Zhang-JK/Terminal-One/document/manual/dsi-screen.png

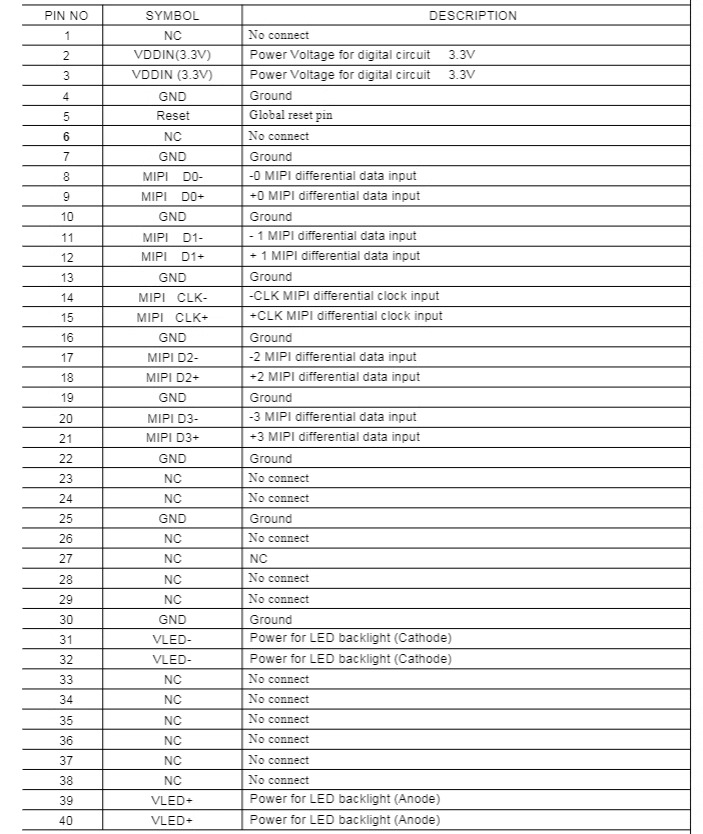
document/manual/dsi-screen.png
