Zhang-JK/Terminal-One/document/manual/mq_sch_v1.6.pdf

# 10uFC30

# 0.1uF R11

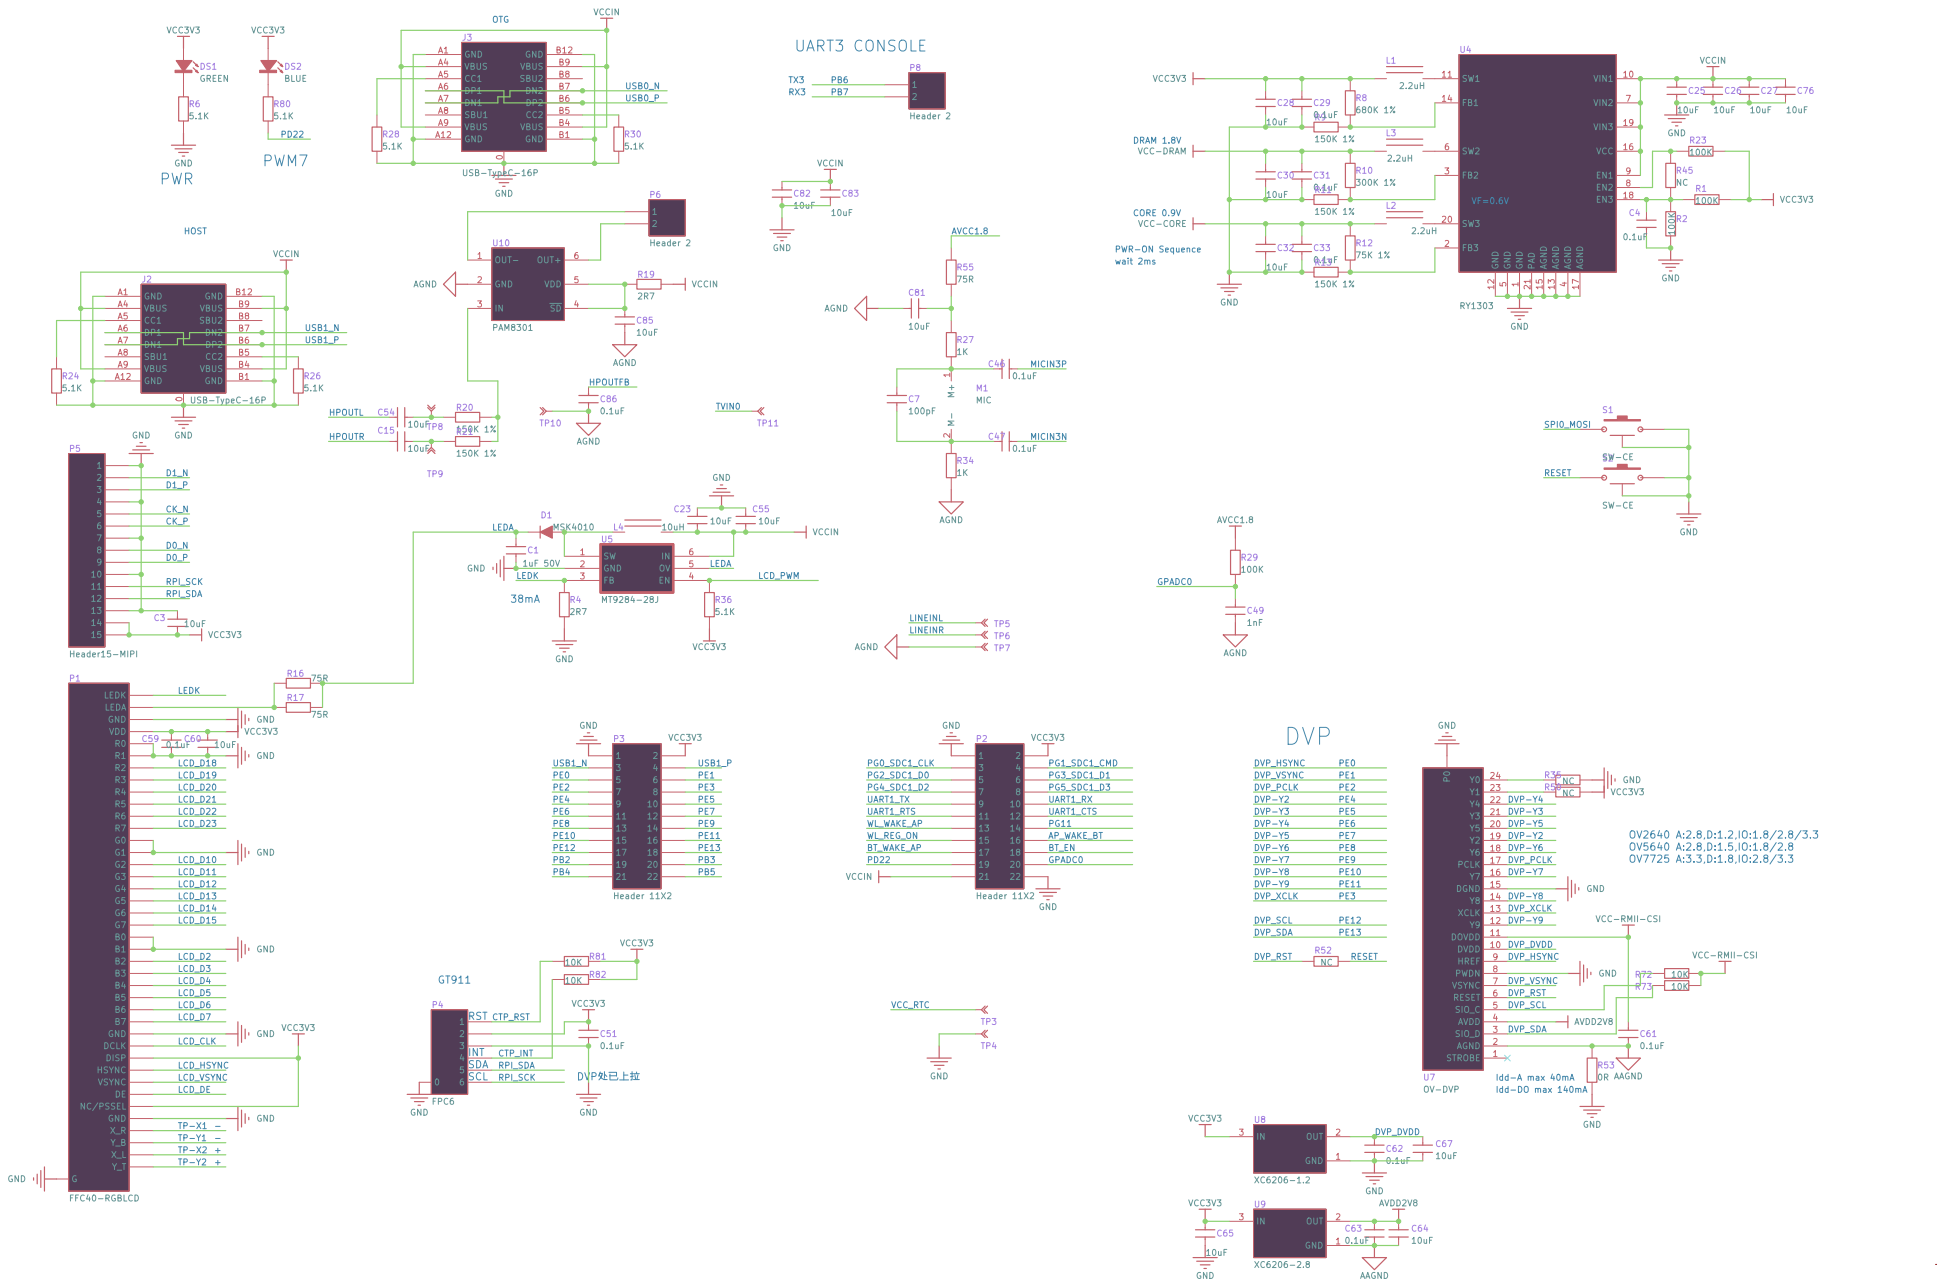
[picture p2: page 1]

0 GND A1 GND A12 VBUS A4 CC1 A5 DP1 A6 DN1 A7 SBU1 A8 VBUS A9 GND B1 GND B12 VBUS B4 CC2 B5 DP2 B6 DN2 B7 SBU2 B8 VBUS B9

1 VIN1 10 SW1 11 GND 12 AGND 13 FB1 14 AGND 15 VCC 16 AGND 17 EN3 18 VIN3 19 FB3 2 SW3 20 PAD 21 FB2 3 AGND

PWR-ON Sequence wait 2ms CORE 0.9V

VCC-RMII-CSI

VSYNC
DE NC/PSSEL GND

VCC3V3 | R84 NC
100K R¹⁴ NC/100K GND | R⁶⁸ ⁴⁷K

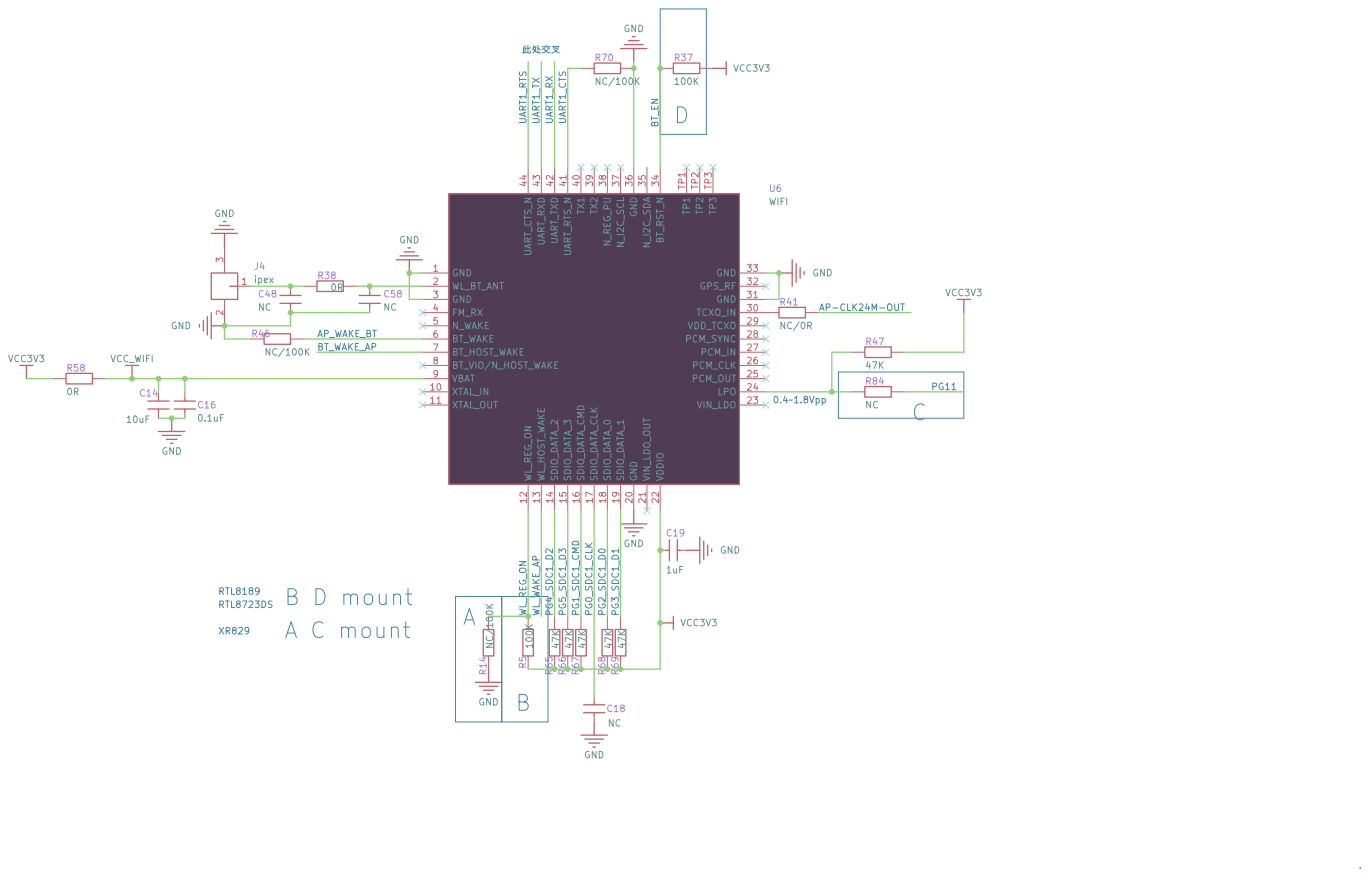
[picture p3: page 2]

þÿkdYN¤SÉ
R70 NC/100K R⁶⁵ ⁴⁷K R⁵ ¹⁰⁰K

# 0.1uFR48

# 10K GND

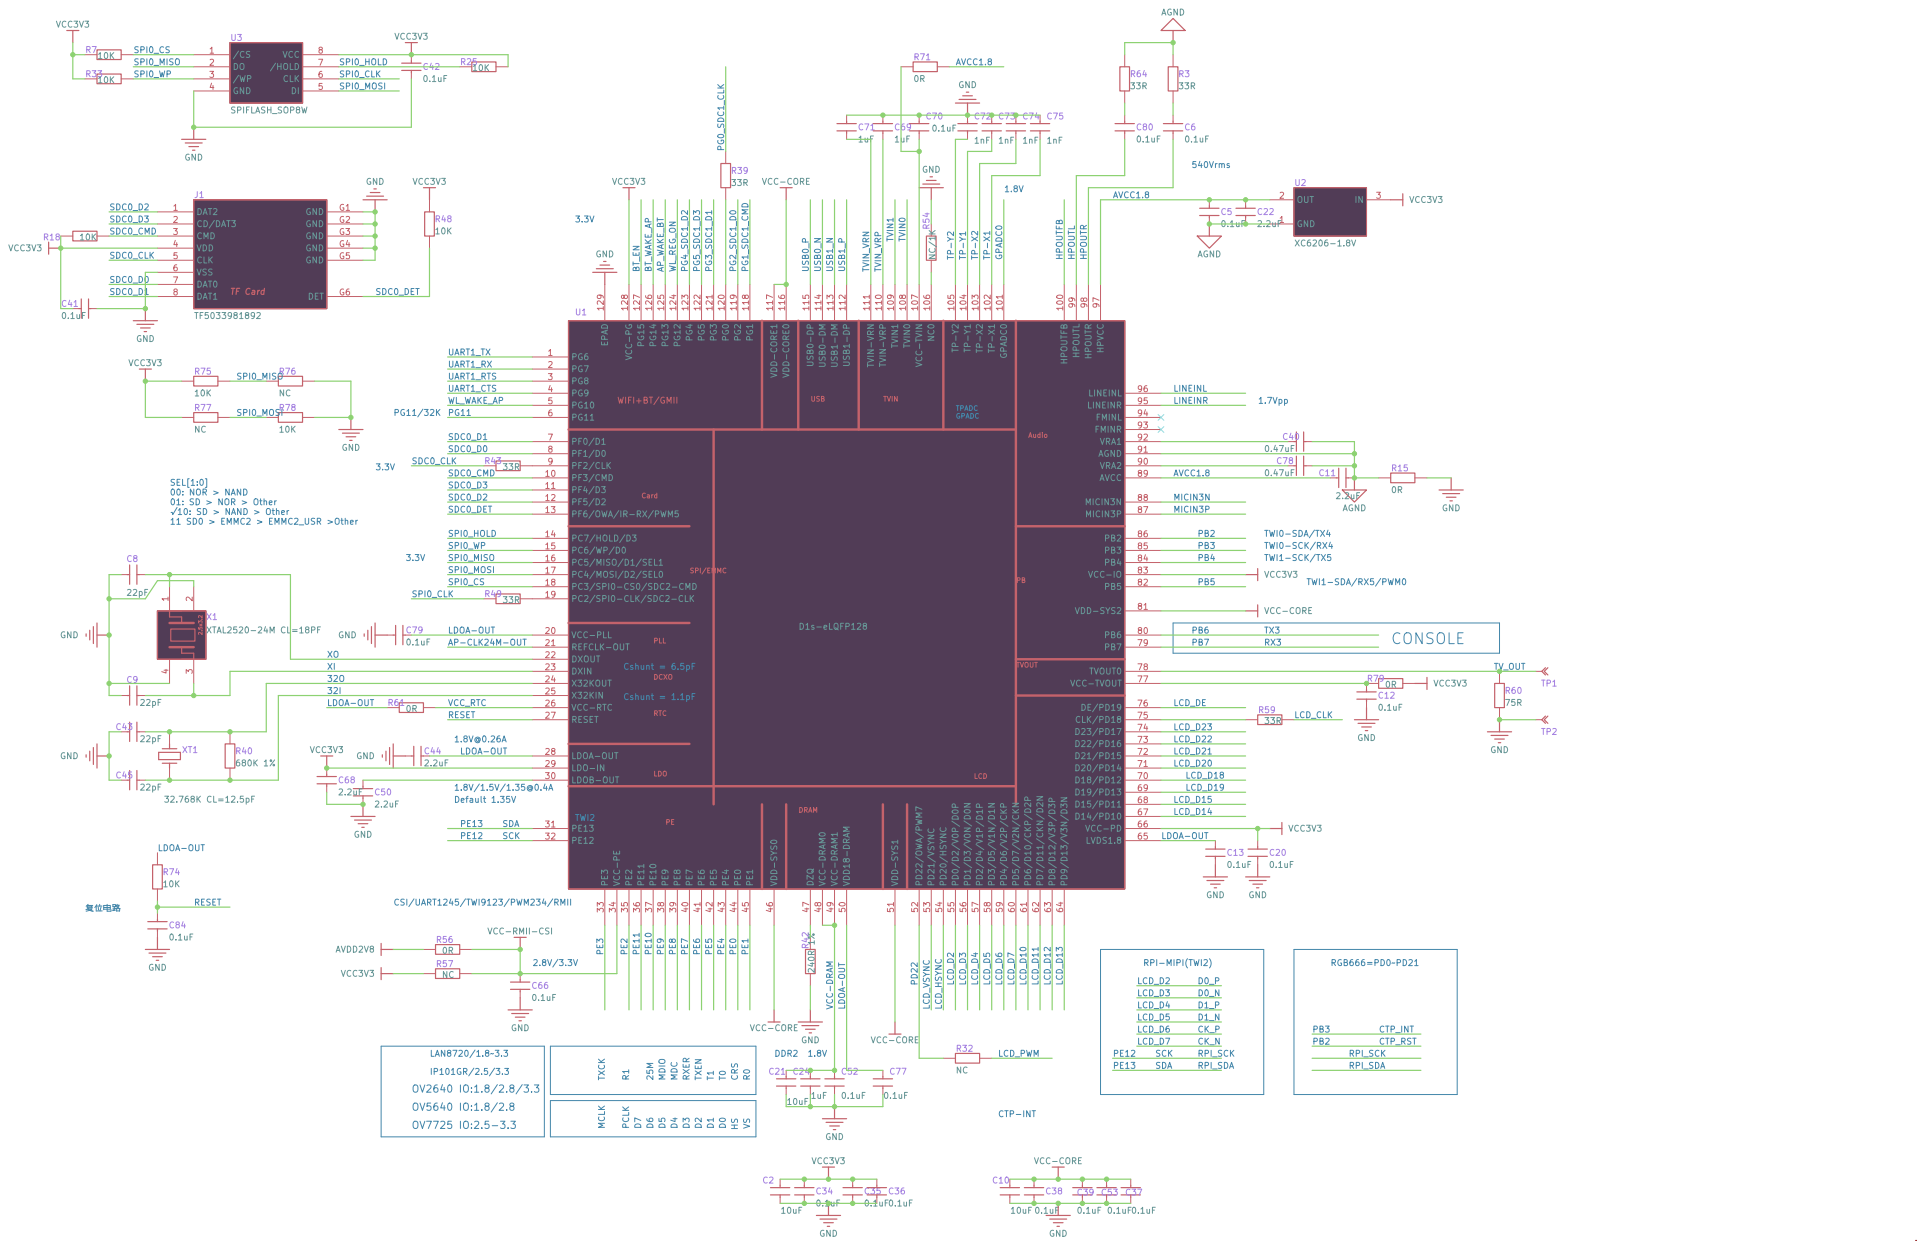
[picture p4: page 3]

OV2640 IO:1.8/2.8/3.3 CSI/UART1245/TWI9123/PWM234/RMII OV7725 IO:2.5-3.3
