Zhang-JK/Terminal-One/hardware/Terminal-One-Core-V1.0/output.pdf

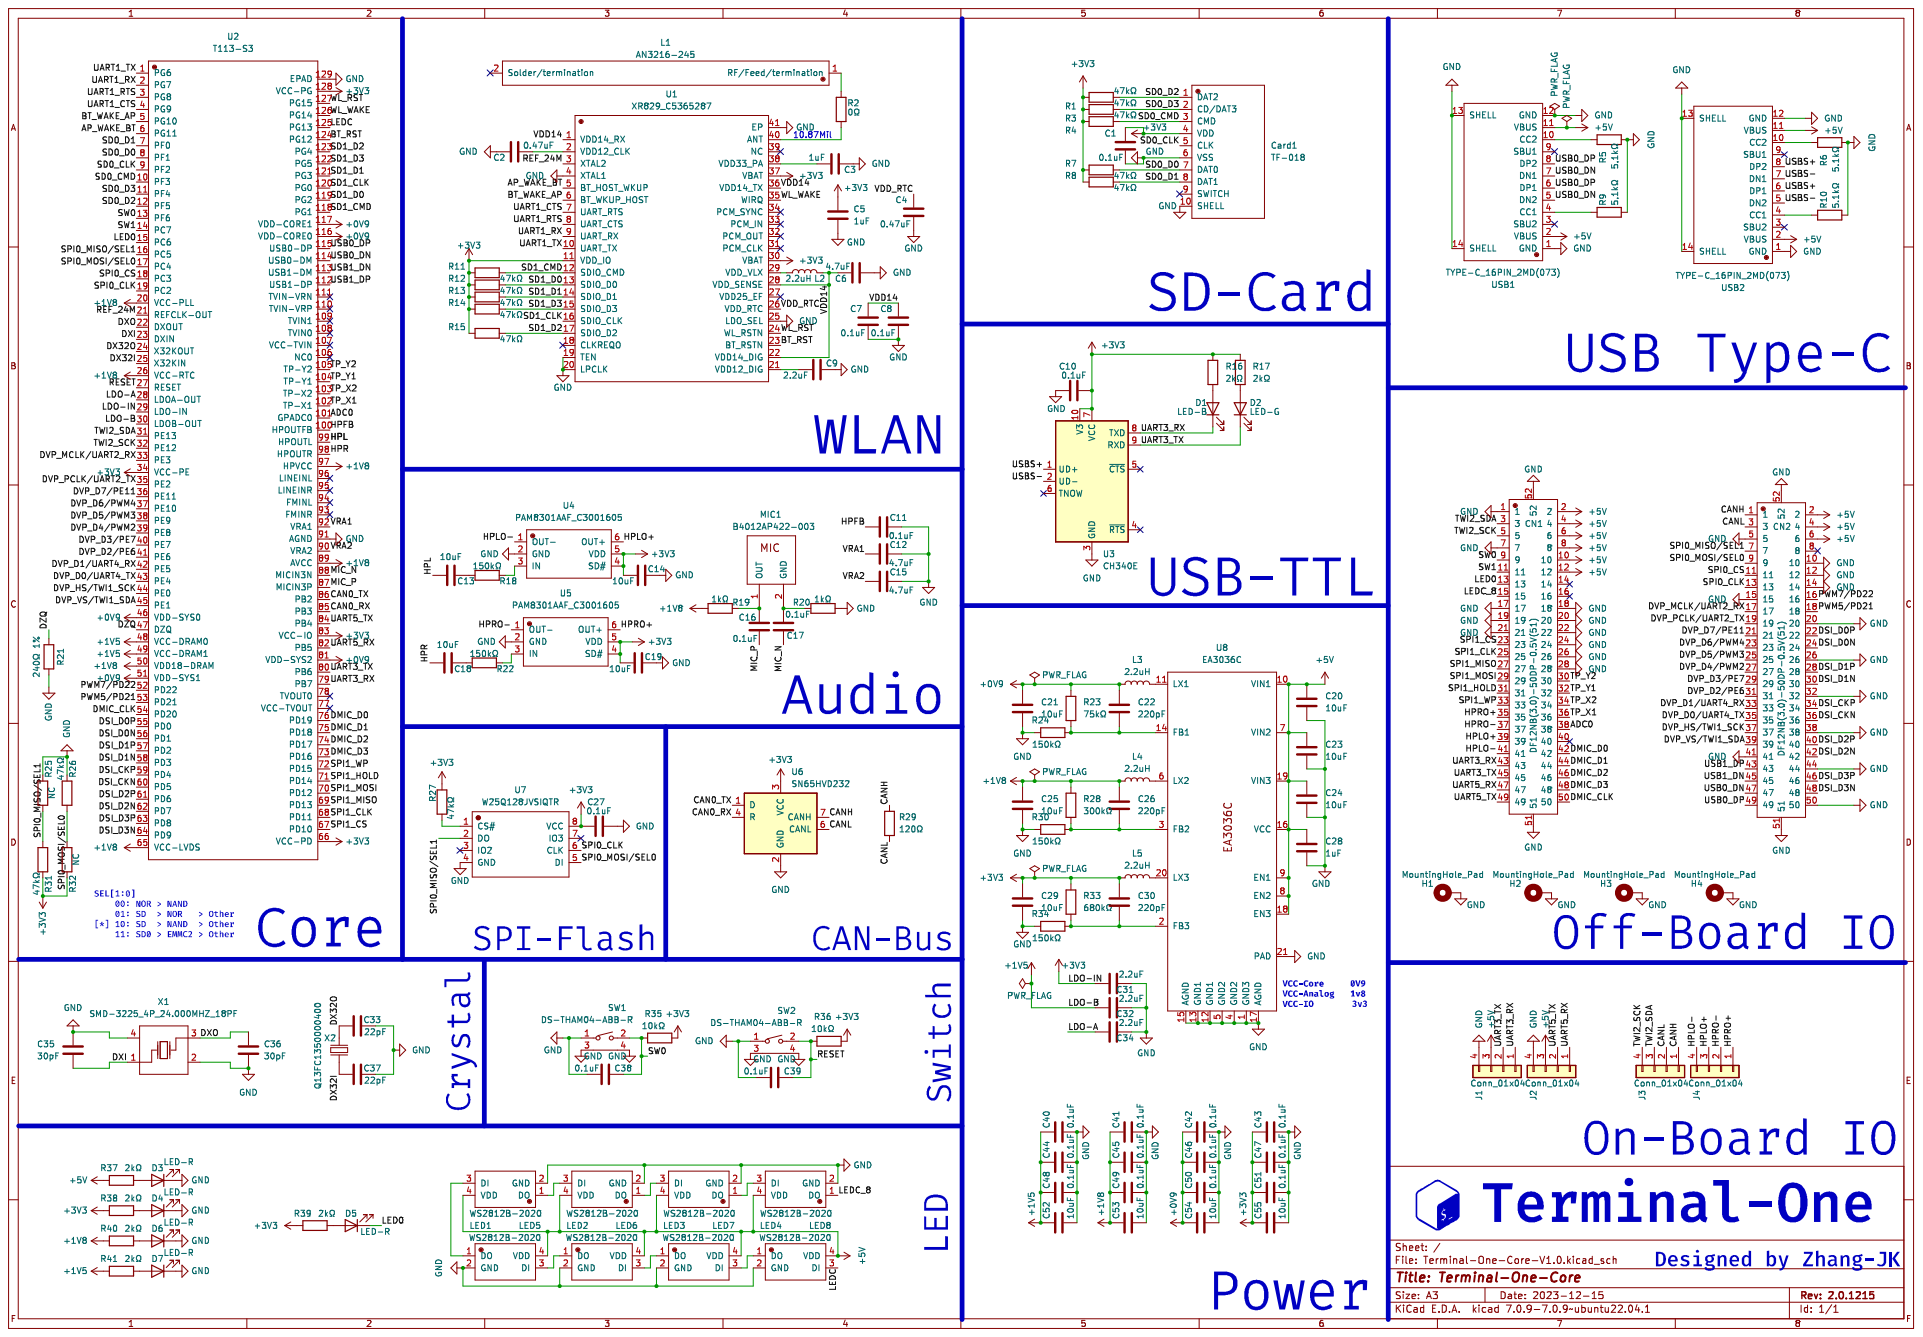
[picture p5: page 1]
