Zhang-JK/Terminal-One/document/manual/14B61A54B428316ECD5F41CF69417D76.pdf

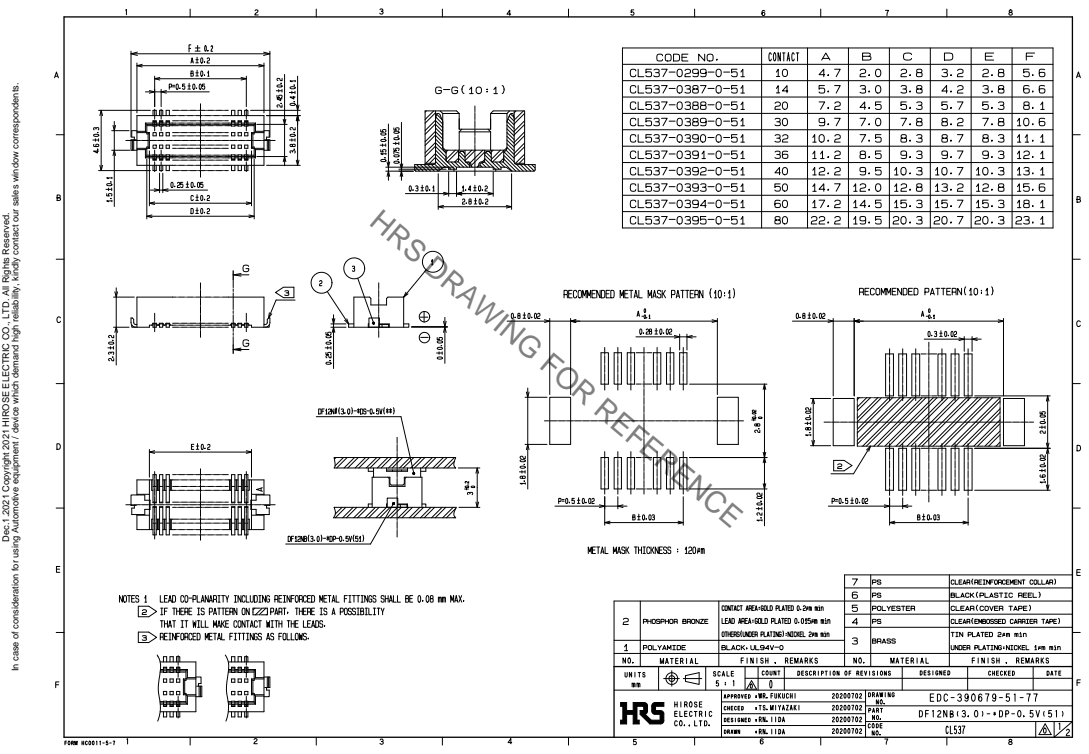
[picture p6: page 1]

HRS DRAWING FOR REFERENCE

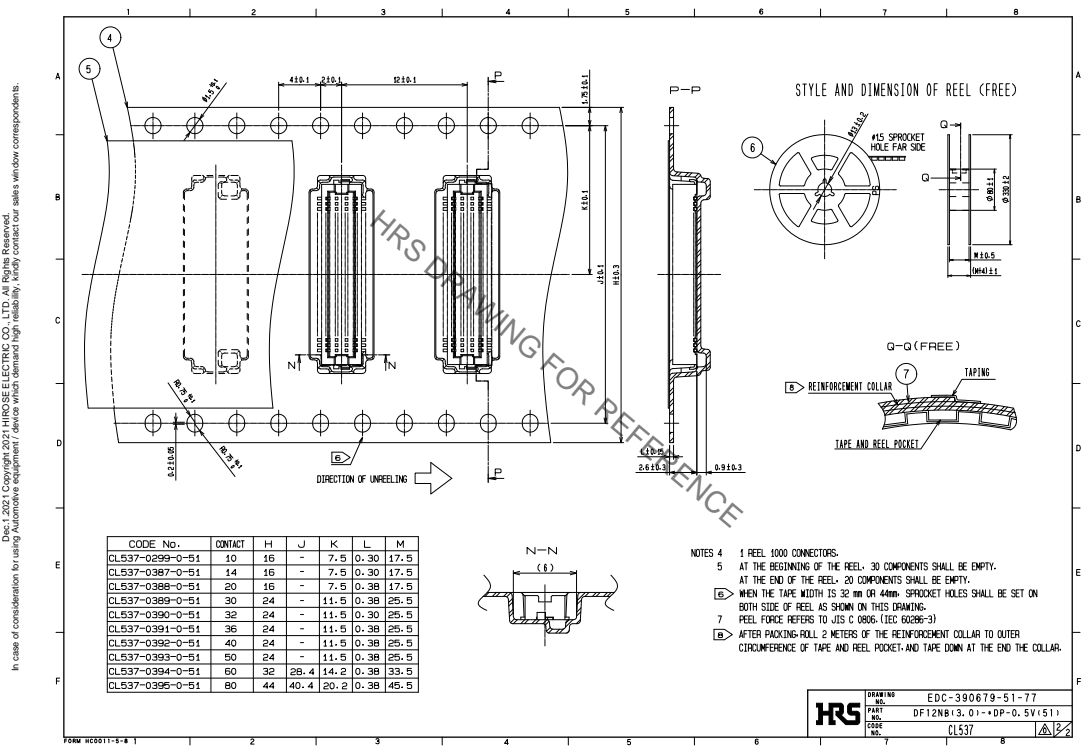
[picture p7: page 2]

HRS DRAWING FOR REFERENCE
