Zhang-JK/Terminal-One/hardware/Terminal-One-Core-V1.0/Terminal-One-Core-V1.0.kicad_pcb

## KiCad design hardware/Terminal-One-Core-V1.0/Terminal-One-Core-V1.0.kicad_pcb (2024-01-20)

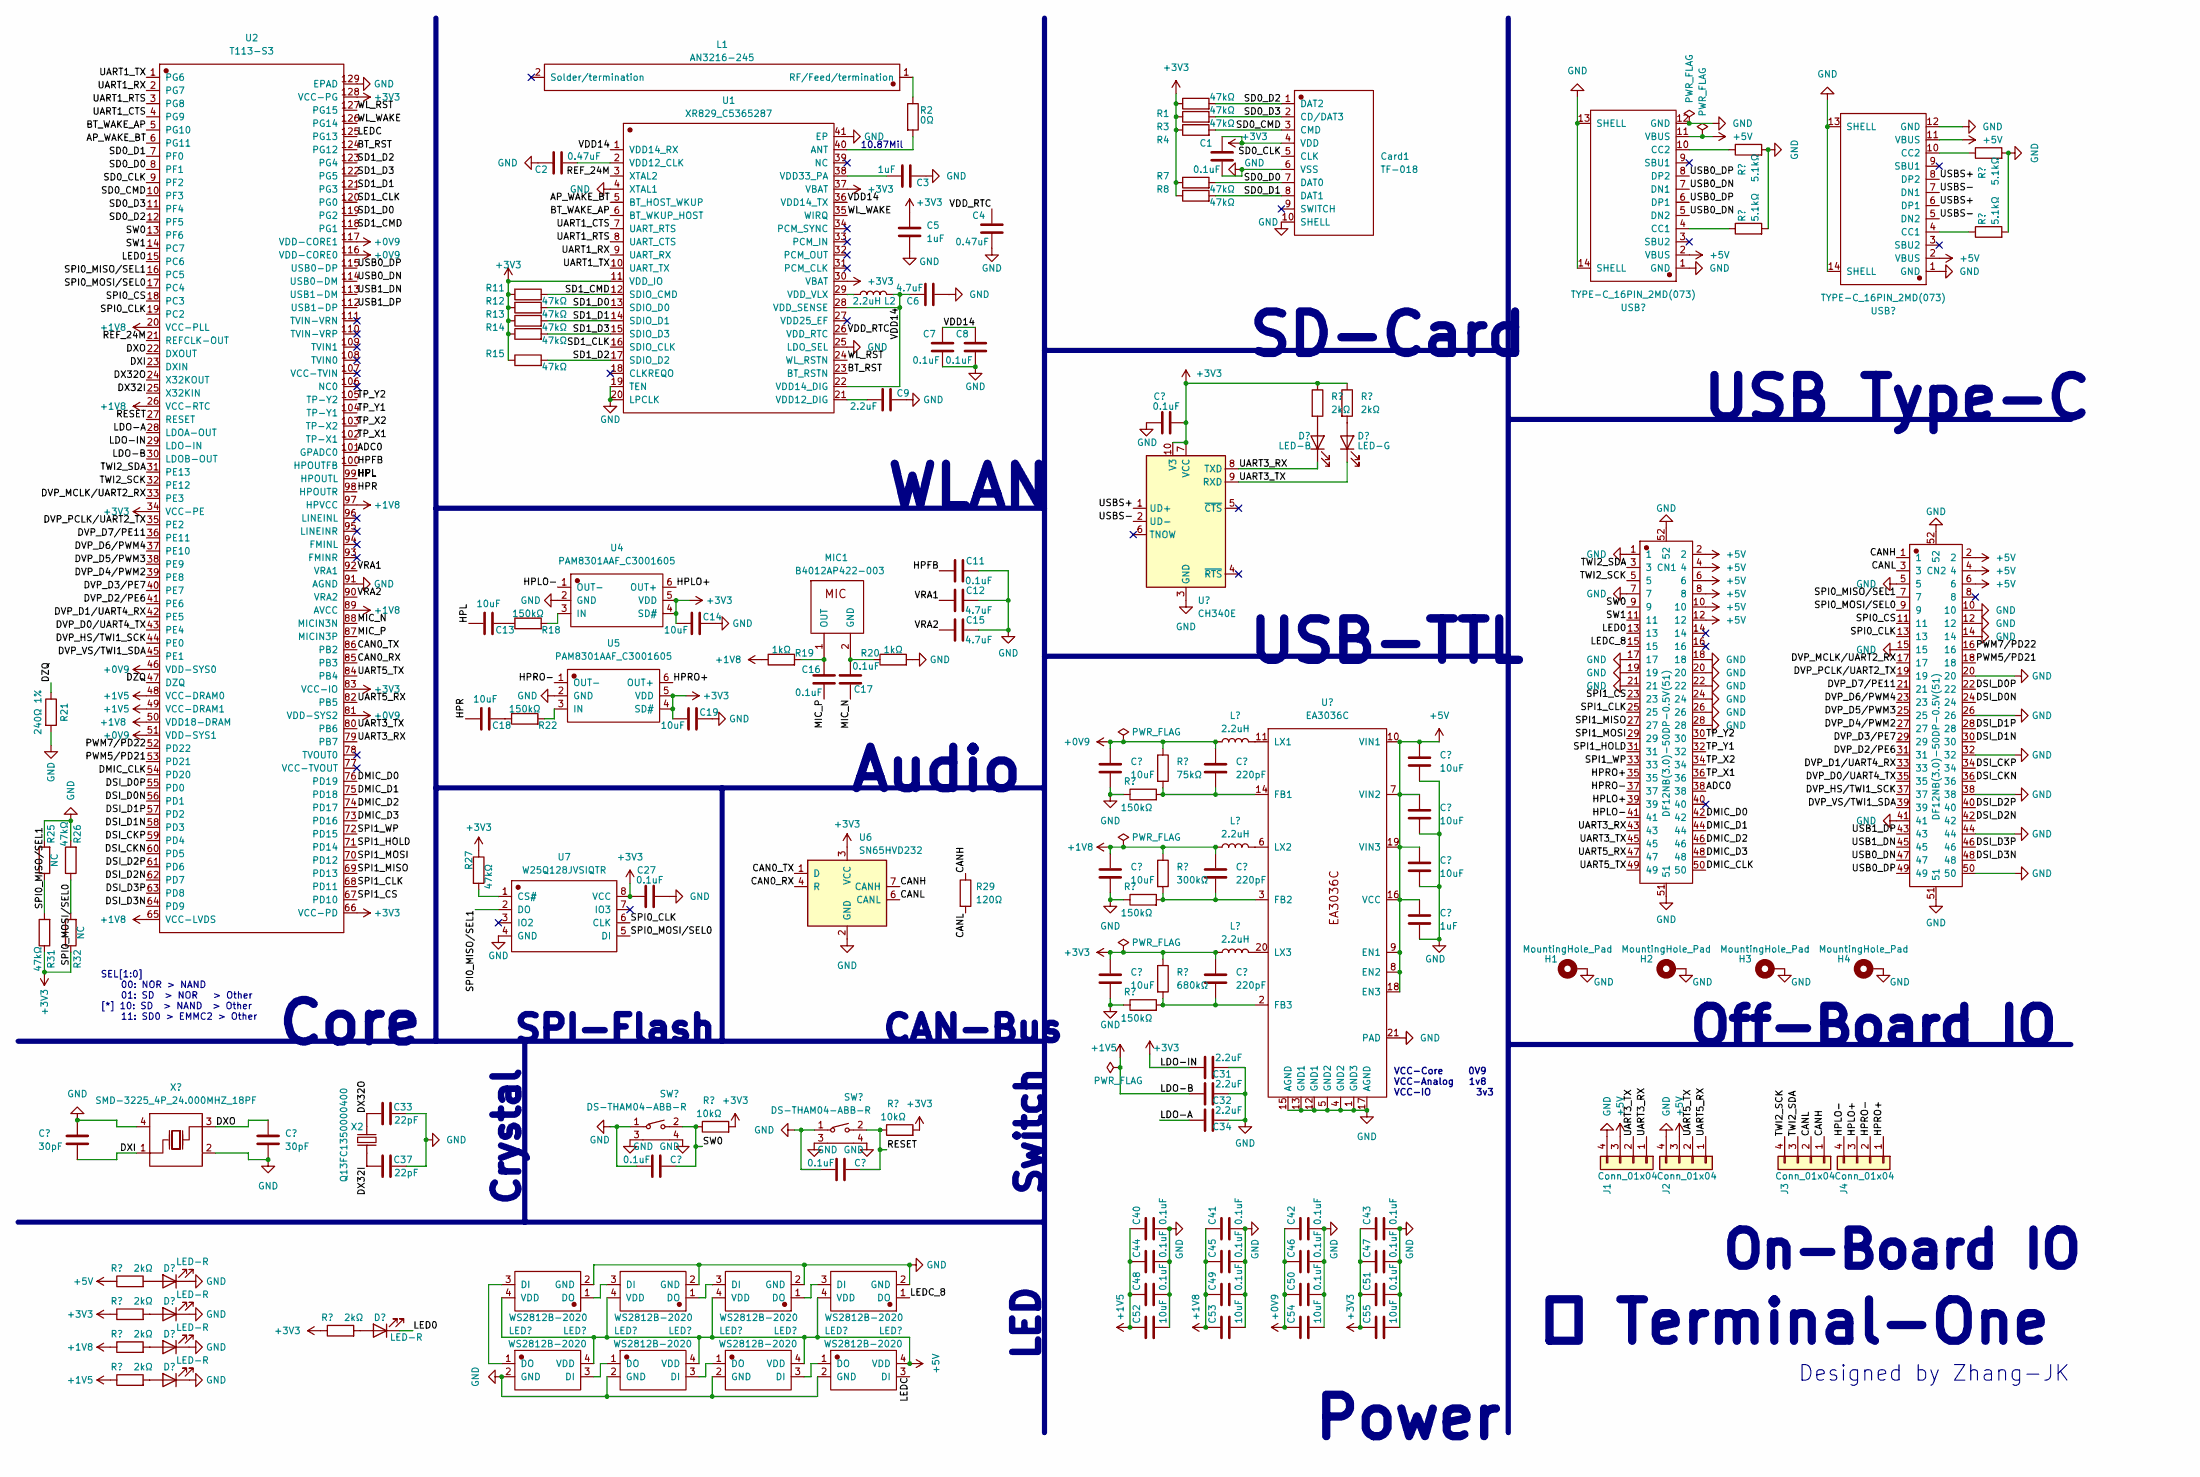
[picture p8: schematic Terminal-One-Core-V1.0.kicad_sch, Terminal-One-Core]

Parts:
C1, C7, C8, C10, C11, C16, C17, C27, C38, C39, C40, C41, C42, C43, C44, C45, C46, C47, C48, C49, C50, C51: 0.1uF; C_0402_1005Metric
C2, C4: 0.47uF; C_0402_1005Metric
C3, C5, C28: 1uF; C_0402_1005Metric
C6, C12, C15: 4.7uF; C_0603_1608Metric
C9, C31, C32, C34: 2.2uF; C_0603_1608Metric
C13, C14, C18, C19, C20, C23, C24, C52, C53, C54, C55: 10uF; C_0603_1608Metric
C21, C25, C29: 10uF; C_0805_2012Metric
C22, C26, C30: 220pF; C_0603_1608Metric
C33, C37: 22pF; C_0402_1005Metric
C35, C36: 30pF; C_0402_1005Metric
CN1, CN2: DF12NB(3.0)-50DP-0.5V(51); CONN-SMD_50P-P0.50_DF12NB3.0-50DP-0.5V-51
Card1: TF-018; TF-SMD_TF-018
D1: LED-B; LED_0603_1608Metric
D2: LED-G; LED_0603_1608Metric
D3, D4, D5, D6, D7: LED-R; LED_0603_1608Metric
H1, H2, H3, H4: MountingHole_Pad; MountingHole_2.7mm_M2.5_ISO14580_Pad_TopOnly
J1, J2, J3, J4: Conn_01x04; JST_GH_BM04B-GHS-TBT_1x04-1MP_P1.25mm_Vertical
L1: AN3216-245; ANT-SMD_L3.2-W1.6-A
L2, L3, L4, L5: 2.2uH; L_0805_2012Metric
LED1, LED2, LED3, LED4, LED5, LED6, LED7, LED8: WS2812B-2020; LED-SMD_4P-L2.0-W2.0-TL_WS2812B-2020
MIC1: B4012AP422-003; MIC-TH_BD4.0-P1.40-D0.3-L
R1, R3, R4, R7, R8, R11, R12, R13, R14, R15, R26, R27, R31: 47kΩ; R_0402_1005Metric
R2: 0Ω; R_0402_1005Metric
R5, R6, R9, R10: 5.1kΩ; R_0402_1005Metric
R16, R17, R37, R38, R39, R40, R41: 2kΩ; R_0402_1005Metric
R18, R22, R24, R30, R34: 150kΩ; R_0402_1005Metric
R19, R20: 1kΩ; R_0402_1005Metric
R21: 240Ω 1%; R_0402_1005Metric
R23: 75kΩ; R_0402_1005Metric
R25, R32: NC; R_0402_1005Metric
R28: 300kΩ; R_0402_1005Metric
R29: 120Ω; R_0402_1005Metric
R33: 680kΩ; R_0402_1005Metric
R35, R36: 10kΩ; R_0402_1005Metric
SW1, SW2: DS-THAM04-ABB-R; SW-SMD_D-SWITCH_DS-THAM04-ABB-R
U1: XR829_C5365287; QFN-40_L5.0-W5.0-P0.40-BL-EP3.4
U2: T113-S3; TQFP-128_L14.0-W14.0-P0.40-LS16.0-BL-EP6.4
U3: CH340E; MSOP-10_3x3mm_P0.5mm
U4, U5: PAM8301AAF_C3001605; SOT-23-6_L2.9-W1.6-P0.95-LS2.8-BR
U6: SN65HVD232; SOIC-8_3.9x4.9mm_P1.27mm
U7: W25Q128JVSIQTR; SOIC-8_L5.3-W5.3-P1.27-LS8.0-BL
U8: EA3036C; WQFN-20-1EP_3x3mm_P0.4mm_EP1.7x1.7mm_ThermalVias
USB1, USB2: TYPE-C_16PIN_2MD(073); USB-C-SMD_TYPE-C-6PIN-2MD-073
X1: SMD-3225_4P_24.000MHZ_18PF; CRYSTAL-SMD_4P-L3.2-W2.5-BL
X2: Q13FC1350000400; FC-135R_L3.2-W1.5

Connections:
+0V9: C21.1, C22.1, C42.1, C46.1, C50.1, C54.1, L3.1, R23.1, U2.46 (VDD-SYS0), U2.51 (VDD-SYS1), U2.81 (VDD-SYS2), U2.116 (VDD-CORE0), U2.117 (VDD-CORE1); also elsewhere on the board
+1V5: C32.1, C40.1, C44.1, C48.1, C52.1, R41.1, U2.30 (LDOB-OUT), U2.48 (VCC-DRAM0), U2.49 (VCC-DRAM1); also elsewhere on the board
+1V8: C25.1, C26.1, C41.1, C45.1, C49.1, C53.1, L4.1, R19.1, R28.1, R40.1, U2.20 (VCC-PLL), U2.26 (VCC-RTC), U2.50 (VDD18-DRAM), U2.65 (VCC-LVDS), U2.89 (AVCC), U2.97 (HPVCC); also elsewhere on the board
+3V3: C1.1, C5.1, C10.2, C14.1, C19.1, C27.1, C29.1, C30.1, C31.1, C43.1, C47.1, C51.1, C55.1, Card1.4 (VDD), L5.1, R1.1, R3.1, R4.1, R7.1, R8.1, R11.1, R12.1, R13.1, R14.1, R15.1, R16.1, R17.1, R27.1, R31.1, R32.1, R33.1, R35.2, R36.2, R38.1, R39.1, U1.11 (VDD_IO), U1.30 (VBAT), U1.37 (VBAT), U2.29 (LDO-IN), U2.34 (VCC-PE), U2.66 (VCC-PD), U2.83 (VCC-IO), U2.128 (VCC-PG), U3.7 (VCC), U3.10 (V3), U4.4 (SD#), U4.5 (VDD), U5.4 (SD#), U5.5 (VDD), U6.3 (VCC), U7.8 (VCC); also elsewhere on the board
+5V: C20.1, C23.1, C24.1, C28.1, CN1.2, CN1.4, CN1.6, CN1.8, CN1.10, CN1.12, CN2.2, CN2.4, CN2.6, J1.3, J2.3, LED1.4 (VDD), LED2.4 (VDD), LED3.4 (VDD), LED4.4 (VDD), LED5.4 (VDD), LED6.4 (VDD), LED7.4 (VDD), LED8.4 (VDD), R37.1, U8.7 (VIN2), U8.8 (EN2), U8.9 (EN1), U8.10 (VIN1), U8.16 (VCC), U8.18 (EN3), U8.19 (VIN3), USB1.2 (VBUS), USB1.11 (VBUS), USB2.2 (VBUS), USB2.11 (VBUS)
/ADC0: CN1.38, U2.101 (GPADC0); also elsewhere on the board
/AP_WAKE_BT: U1.5 (BT_HOST_WKUP), U2.6 (PG11); also elsewhere on the board
/BT_RST: U1.23 (BT_RSTN), U2.124 (PG12); also elsewhere on the board
/BT_WAKE_AP: U1.6 (BT_WKUP_HOST), U2.5 (PG10); also elsewhere on the board
/CAN0_RX: U2.85 (PB3), U6.4 (R); also elsewhere on the board
/CAN0_TX: U2.86 (PB2), U6.1 (D); also elsewhere on the board
/CANH: CN2.1, J3.1, R29.1, U6.7 (CANH)
/CANL: CN2.3, J3.2, R29.2, U6.6 (CANL)
/DMIC_CLK: CN1.50, U2.54 (PD20); also elsewhere on the board
/DMIC_D0: CN1.42, U2.76 (PD19); also elsewhere on the board
/DMIC_D1: CN1.44, U2.75 (PD18); also elsewhere on the board
/DMIC_D2: CN1.46, U2.74 (PD17); also elsewhere on the board
/DMIC_D3: CN1.48, U2.73 (PD16); also elsewhere on the board
/DSI_CKN: CN2.36, U2.60 (PD5); also elsewhere on the board
/DSI_CKP: CN2.34, U2.59 (PD4); also elsewhere on the board
/DSI_D0N: CN2.24, U2.56 (PD1); also elsewhere on the board
/DSI_D0P: CN2.22, U2.55 (PD0); also elsewhere on the board
/DSI_D1N: CN2.30, U2.58 (PD3); also elsewhere on the board
/DSI_D1P: CN2.28, U2.57 (PD2); also elsewhere on the board
/DSI_D2N: CN2.42, U2.62 (PD7); also elsewhere on the board
/DSI_D2P: CN2.40, U2.61 (PD6); also elsewhere on the board
/DSI_D3N: CN2.48, U2.64 (PD9); also elsewhere on the board
/DSI_D3P: CN2.46, U2.63 (PD8); also elsewhere on the board
/DVP_D0/UART4_TX: CN2.35, U2.43 (PE4); also elsewhere on the board
/DVP_D1/UART4_RX: CN2.33, U2.42 (PE5); also elsewhere on the board
/DVP_D2/PE6: CN2.31, U2.41 (PE6); also elsewhere on the board
/DVP_D3/PE7: CN2.29, U2.40 (PE7); also elsewhere on the board
/DVP_D4/PWM2: CN2.27, U2.39 (PE8); also elsewhere on the board
/DVP_D5/PWM3: CN2.25, U2.38 (PE9); also elsewhere on the board
/DVP_D6/PWM4: CN2.23, U2.37 (PE10); also elsewhere on the board
/DVP_D7/PE11: CN2.21, U2.36 (PE11); also elsewhere on the board
/DVP_HS/TWI1_SCK: CN2.37, U2.44 (PE0); also elsewhere on the board
/DVP_MCLK/UART2_RX: CN2.17, U2.33 (PE3); also elsewhere on the board
/DVP_PCLK/UART2_TX: CN2.19, U2.35 (PE2); also elsewhere on the board
/DVP_VS/TWI1_SDA: CN2.39, U2.45 (PE1); also elsewhere on the board
/DX32I: C37.1, U2.25 (X32KIN), X2.1; also elsewhere on the board
/DX32O: C33.1, U2.24 (X32KOUT), X2.2; also elsewhere on the board
/DXI: C35.2, U2.23 (DXIN), X1.1 (OSC1); also elsewhere on the board
/DXO: C36.1, U2.22 (DXOUT), X1.3 (OSC2); also elsewhere on the board
/DZQ: R21.1, U2.47 (DZQ); also elsewhere on the board
/HPFB: C11.1, U2.100 (HPOUTFB); also elsewhere on the board
/HPL: C13.2, U2.99 (HPOUTL); also elsewhere on the board
/HPLO+: CN1.39, J4.3, U4.6 (OUT+)
/HPLO-: CN1.41, J4.4, U4.1 (OUT-)
/HPR: C18.2, U2.98 (HPOUTR); also elsewhere on the board
/HPRO+: CN1.35, J4.1, U5.6 (OUT+)
/HPRO-: CN1.37, J4.2, U5.1 (OUT-)
/LDO-A: C34.1, U2.28 (LDOA-OUT); also elsewhere on the board
/LED0: CN1.13, D5.1 (K), U2.15 (PC6); also elsewhere on the board
/LEDC: LED8.3 (DI), U2.125 (PG13); also elsewhere on the board
/LEDC_8: CN1.15, LED4.1 (DO)
/MIC_N: C17.2, U2.88 (MICIN3N); also elsewhere on the board
/MIC_P: C16.1, U2.87 (MICIN3P); also elsewhere on the board
/PWM5/PD21: CN2.18, U2.53 (PD21); also elsewhere on the board
/PWM7/PD22: CN2.16, U2.52 (PD22); also elsewhere on the board
/REF_24M: U1.3 (XTAL2), U2.21 (REFCLK-OUT); also elsewhere on the board
/RESET: C39.2, R36.1, SW2.2, U2.27 (RESET); also elsewhere on the board
/SD0_CLK: Card1.5 (CLK), U2.9 (PF2); also elsewhere on the board
/SD0_CMD: Card1.3 (CMD), R4.2, U2.10 (PF3); also elsewhere on the board
/SD0_D0: Card1.7 (DAT0), R7.2, U2.8 (PF1); also elsewhere on the board
/SD0_D1: Card1.8 (DAT1), R8.2, U2.7 (PF0); also elsewhere on the board
/SD0_D2: Card1.1 (DAT2), R1.2, U2.12 (PF5); also elsewhere on the board
/SD0_D3: Card1.2 (CD/DAT3), R3.2, U2.11 (PF4); also elsewhere on the board
/SD1_CLK: U1.16 (SDIO_CLK), U2.120 (PG0); also elsewhere on the board
/SD1_CMD: R11.2, U1.12 (SDIO_CMD), U2.118 (PG1); also elsewhere on the board
/SD1_D0: R12.2, U1.13 (SDIO_D0), U2.119 (PG2); also elsewhere on the board
/SD1_D1: R13.2, U1.14 (SDIO_D1), U2.121 (PG3); also elsewhere on the board
/SD1_D2: R15.2, U1.17 (SDIO_D2), U2.123 (PG4); also elsewhere on the board
/SD1_D3: R14.2, U1.15 (SDIO_D3), U2.122 (PG5); also elsewhere on the board
/SPI0_CLK: CN2.13, U2.19 (PC2), U7.6 (CLK); also elsewhere on the board
/SPI0_CS: CN2.11, U2.18 (PC3); also elsewhere on the board
/SPI0_MISO/SEL1: CN2.7, R25.1, R31.2, U2.16 (PC5), U7.2 (DO); also elsewhere on the board
/SPI0_MOSI/SEL0: CN2.9, R26.1, R32.2, U2.17 (PC4), U7.5 (DI); also elsewhere on the board
/SPI1_CLK: CN1.25, U2.68 (PD11); also elsewhere on the board
/SPI1_CS: CN1.23, U2.67 (PD10); also elsewhere on the board
/SPI1_HOLD: CN1.31, U2.71 (PD14); also elsewhere on the board
/SPI1_MISO: CN1.27, U2.69 (PD13); also elsewhere on the board
/SPI1_MOSI: CN1.29, U2.70 (PD12); also elsewhere on the board
/SPI1_WP: CN1.33, U2.72 (PD15); also elsewhere on the board
/SW0: C38.2, CN1.9, R35.1, SW1.2, U2.13 (PF6); also elsewhere on the board
/SW1: CN1.11, U2.14 (PC7); also elsewhere on the board
/TP_X1: CN1.36, U2.102 (TP-X1); also elsewhere on the board
/TP_X2: CN1.34, U2.103 (TP-X2); also elsewhere on the board
/TP_Y1: CN1.32, U2.104 (TP-Y1); also elsewhere on the board
/TP_Y2: CN1.30, U2.105 (TP-Y2); also elsewhere on the board
/TWI2_SCK: CN1.5, J3.4, U2.32 (PE12); also elsewhere on the board
/TWI2_SDA: CN1.3, J3.3, U2.31 (PE13); also elsewhere on the board
/UART1_CTS: U1.7 (UART_RTS), U2.4 (PG9); also elsewhere on the board
/UART1_RTS: U1.8 (UART_CTS), U2.3 (PG8); also elsewhere on the board
/UART1_RX: U1.9 (UART_RX), U2.2 (PG7); also elsewhere on the board
/UART1_TX: U1.10 (UART_TX), U2.1 (PG6); also elsewhere on the board
/UART3_RX: CN1.43, D1.1 (K), J1.1, U2.79 (PB7), U3.8 (TXD); also elsewhere on the board
/UART3_TX: CN1.45, D2.1 (K), J1.2, U2.80 (PB6), U3.9 (RXD); also elsewhere on the board
/UART5_RX: CN1.47, J2.1, U2.82 (PB5); also elsewhere on the board
/UART5_TX: CN1.49, J2.2, U2.84 (PB4); also elsewhere on the board
/USB0_DN: CN2.47, U2.114 (USB0-DM), USB1.5 (DN2), USB1.7 (DN1); also elsewhere on the board
/USB0_DP: CN2.49, U2.115 (USB0-DP), USB1.6 (DP1), USB1.8 (DP2); also elsewhere on the board
/USB1_DN: CN2.45, U2.113 (USB1-DM); also elsewhere on the board
/USB1_DP: CN2.43, U2.112 (USB1-DP); also elsewhere on the board
/USBS+: U3.1 (UD+), USB2.6 (DP1), USB2.8 (DP2)
/USBS-: U3.2 (UD-), USB2.5 (DN2), USB2.7 (DN1)
/VDD14: C6.1, C7.2, C8.2, L2.2, U1.1 (VDD14_RX), U1.22 (VDD14_DIG), U1.28 (VDD_SENSE), U1.36 (VDD14_TX)
/VDD_RTC: C4.2, U1.26 (VDD_RTC)
/VRA1: C12.1, U2.92 (VRA1); also elsewhere on the board
/VRA2: C15.1, U2.90 (VRA2); also elsewhere on the board
/WL_RST: U1.24 (WL_RSTN), U2.127 (PG15); also elsewhere on the board
/WL_WAKE: U1.35 (WIRQ), U2.126 (PG14); also elsewhere on the board
GND: C1.2, C2.2, C3.2, C4.1, C5.2, C6.2, C7.1, C8.1, C9.1, C10.1, C11.2, C12.2, C14.2, C15.2, C19.2, C20.2, C21.2, C23.2, C24.2, C25.2, C27.2, C28.2, C29.2, C31.2, C32.2, C33.2, C34.2, C35.1, C36.2, C37.2, C38.1, C39.1, C40.2, C41.2, C42.2, C43.2, C44.2, C45.2, C46.2, C47.2, C48.2, C49.2, C50.2, C51.2, C52.2, C53.2, C54.2, C55.2, CN1.1, CN1.7, CN1.17, CN1.18, CN1.19, CN1.20, CN1.21, CN1.22, CN1.24, CN1.26, CN1.28, CN1.51, CN1.52, CN2.5, CN2.10, CN2.12, CN2.14, CN2.15, CN2.20, CN2.26, CN2.32, CN2.38, CN2.41, CN2.44, CN2.50, CN2.51, CN2.52, Card1.6 (VSS), Card1.10 (SHELL), D3.1 (K), D4.1 (K), D6.1 (K), D7.1 (K), H1.1, H2.1, H3.1, H4.1, J1.4, J2.4, LED1.2 (GND), LED2.2 (GND), LED3.2 (GND), LED4.2 (GND), LED5.2 (GND), LED6.2 (GND), LED7.2 (GND), LED8.2 (GND), R5.2, R6.2, R9.2, R10.2, R20.2, R21.2, R24.1, R25.2, R26.2, R30.1, R34.1, SW1.1, SW1.3, SW1.4, SW2.1, SW2.3, SW2.4, U1.4 (XTAL1), U1.19 (TEN), U1.20 (LPCLK), U1.25 (LDO_SEL), U1.41 (EP), U2.91 (AGND), U2.129 (EPAD), U3.3 (GND), U4.2 (GND), U5.2 (GND), U6.2 (GND), U7.4 (GND), U8.1 (GND3), U8.4 (GND2), U8.5 (GND2), U8.12 (GND1), U8.13 (GND1), U8.15 (AGND), U8.17 (AGND), U8.21 (PAD), USB1.1 (GND), USB1.12 (GND), USB1.13 (SHELL), USB1.14 (SHELL), USB2.1 (GND), USB2.12 (GND), USB2.13 (SHELL), USB2.14 (SHELL), X1.2 (GND), X1.4 (GND); also elsewhere on the board
unnamed: C13.1, R18.1
unnamed: C18.1, R22.1
unnamed: D1.2 (A), R16.2
unnamed: D2.2 (A), R17.2
unnamed: D3.2 (A), R37.2
unnamed: D4.2 (A), R38.2
unnamed: D5.2 (A), R39.2
unnamed: D6.2 (A), R40.2
unnamed: D7.2 (A), R41.2
unnamed: L1.1 (RF/Feed/termination), R2.1
unnamed: LED1.3 (DI), LED5.1 (DO)
unnamed: LED1.1 (DO), LED2.3 (DI)
unnamed: LED2.1 (DO), LED3.3 (DI)
unnamed: LED3.1 (DO), LED4.3 (DI)
unnamed: LED5.3 (DI), LED6.1 (DO)
unnamed: LED6.3 (DI), LED7.1 (DO)
unnamed: LED7.3 (DI), LED8.1 (DO)
unnamed: C17.1, MIC1.2 (GND), R20.1
unnamed: C16.2, MIC1.1 (OUT), R19.2
unnamed: R2.2, U1.40 (ANT)
unnamed: C2.1, U1.2 (VDD12_CLK)
unnamed: C9.2, U1.21 (VDD12_DIG)
unnamed: C3.1, U1.38 (VDD33_PA)
unnamed: L2.1, U1.29 (VDD_VLX)
unnamed: R18.2, U4.3 (IN)
unnamed: R22.2, U5.3 (IN)
unnamed: R27.2, U7.1 (CS#)
unnamed: C22.2, R23.2, R24.2, U8.14 (FB1)
unnamed: C26.2, R28.2, R30.2, U8.3 (FB2)
unnamed: C30.2, R33.2, R34.2, U8.2 (FB3)
unnamed: L3.2, U8.11 (LX1)
unnamed: L4.2, U8.6 (LX2)
unnamed: L5.2, U8.20 (LX3)
unnamed: R9.1, USB1.4 (CC1)
unnamed: R5.1, USB1.10 (CC2)
unnamed: R10.1, USB2.4 (CC1)
unnamed: R6.1, USB2.10 (CC2)

Notes on the sheet:
Audio
CAN-Bus
Off-Board IO
USB-TTL
Switch
LED
USB Type-C
Designed by Zhang-JK
WLAN
 Terminal-One
Power
SPI-Flash
Core
Crystal
SD-Card
10.87Mil
On-Board IO
SEL[1:0] 00: NOR > NAND 01: SD > NOR > Other [*] 10: SD > NAND > Other 11: SD0 > EMMC2 > Other
VCC-Core 0V9 VCC-Analog 1v8 VCC-IO 3v3

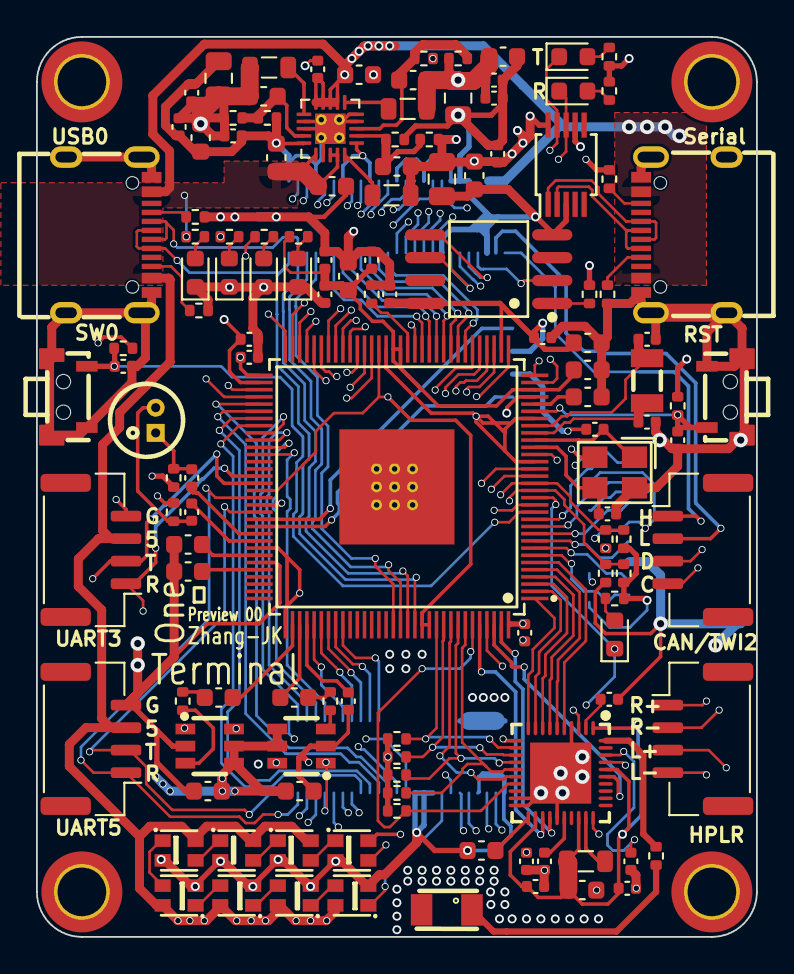
[picture p9: board Terminal-One-Core-V1.0.kicad_pcb from above]

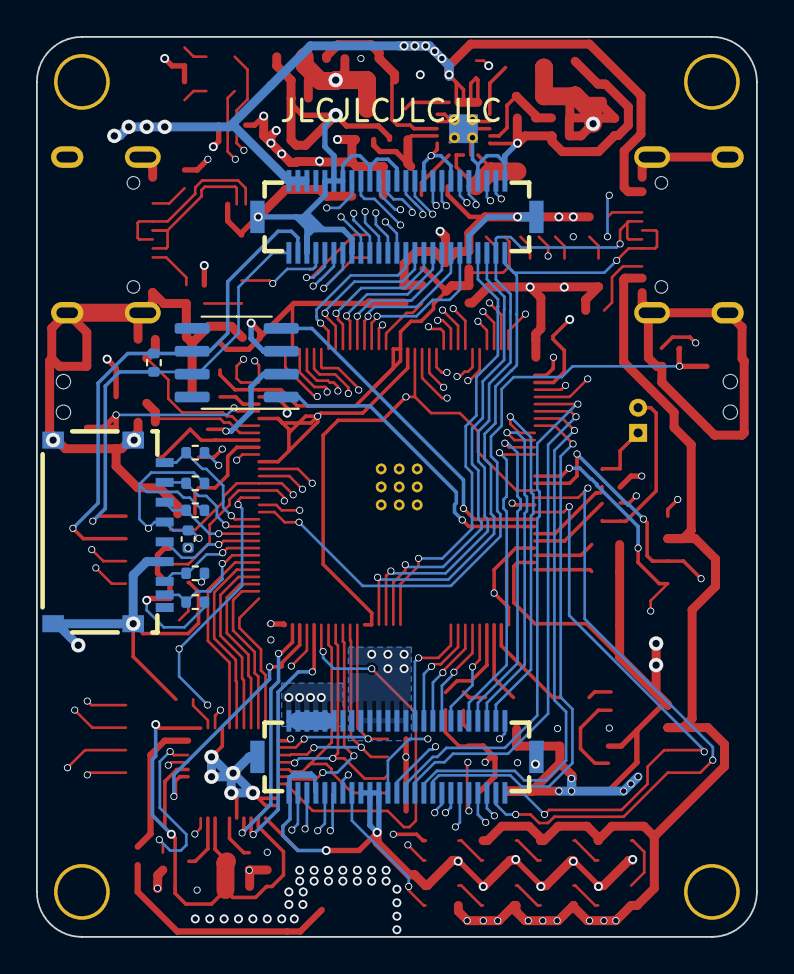
[picture p10: board Terminal-One-Core-V1.0.kicad_pcb from below]

Board: 4 copper layers, 40.0 x 50.0 mm, 142 parts (11 on the bottom side), 150 nets.

Other parts of the board:
Ur: T113-S3; TQFP-128_L14.0-W14.0-P0.40-LS16.0-BL-EP6.4

Their connections:
+0V9: Ur.46 (VDD-SYS0), Ur.51 (VDD-SYS1), Ur.81 (VDD-SYS2), Ur.116 (VDD-CORE0), Ur.117 (VDD-CORE1); also elsewhere on the board
+1V5: Ur.30 (LDOB-OUT), Ur.48 (VCC-DRAM0), Ur.49 (VCC-DRAM1); also elsewhere on the board
+1V8: Ur.20 (VCC-PLL), Ur.26 (VCC-RTC), Ur.50 (VDD18-DRAM), Ur.65 (VCC-LVDS), Ur.89 (AVCC), Ur.97 (HPVCC); also elsewhere on the board
+3V3: Ur.29 (LDO-IN), Ur.34 (VCC-PE), Ur.66 (VCC-PD), Ur.83 (VCC-IO), Ur.128 (VCC-PG); also elsewhere on the board
/ADC0: Ur.101 (GPADC0); also elsewhere on the board
/AP_WAKE_BT: Ur.6 (PG11); also elsewhere on the board
/BT_RST: Ur.124 (PG12); also elsewhere on the board
/BT_WAKE_AP: Ur.5 (PG10); also elsewhere on the board
/CAN0_RX: Ur.85 (PB3); also elsewhere on the board
/CAN0_TX: Ur.86 (PB2); also elsewhere on the board
/DMIC_CLK: Ur.54 (PD20); also elsewhere on the board
/DMIC_D0: Ur.76 (PD19); also elsewhere on the board
/DMIC_D1: Ur.75 (PD18); also elsewhere on the board
/DMIC_D2: Ur.74 (PD17); also elsewhere on the board
/DMIC_D3: Ur.73 (PD16); also elsewhere on the board
/DSI_CKN: Ur.60 (PD5); also elsewhere on the board
/DSI_CKP: Ur.59 (PD4); also elsewhere on the board
/DSI_D0N: Ur.56 (PD1); also elsewhere on the board
/DSI_D0P: Ur.55 (PD0); also elsewhere on the board
/DSI_D1N: Ur.58 (PD3); also elsewhere on the board
/DSI_D1P: Ur.57 (PD2); also elsewhere on the board
/DSI_D2N: Ur.62 (PD7); also elsewhere on the board
/DSI_D2P: Ur.61 (PD6); also elsewhere on the board
/DSI_D3N: Ur.64 (PD9); also elsewhere on the board
/DSI_D3P: Ur.63 (PD8); also elsewhere on the board
/DVP_D0/UART4_TX: Ur.43 (PE4); also elsewhere on the board
/DVP_D1/UART4_RX: Ur.42 (PE5); also elsewhere on the board
/DVP_D2/PE6: Ur.41 (PE6); also elsewhere on the board
/DVP_D3/PE7: Ur.40 (PE7); also elsewhere on the board
/DVP_D4/PWM2: Ur.39 (PE8); also elsewhere on the board
/DVP_D5/PWM3: Ur.38 (PE9); also elsewhere on the board
/DVP_D6/PWM4: Ur.37 (PE10); also elsewhere on the board
/DVP_D7/PE11: Ur.36 (PE11); also elsewhere on the board
/DVP_HS/TWI1_SCK: Ur.44 (PE0); also elsewhere on the board
/DVP_MCLK/UART2_RX: Ur.33 (PE3); also elsewhere on the board
/DVP_PCLK/UART2_TX: Ur.35 (PE2); also elsewhere on the board
/DVP_VS/TWI1_SDA: Ur.45 (PE1); also elsewhere on the board
/DX32I: Ur.25 (X32KIN); also elsewhere on the board
/DX32O: Ur.24 (X32KOUT); also elsewhere on the board
/DXI: Ur.23 (DXIN); also elsewhere on the board
/DXO: Ur.22 (DXOUT); also elsewhere on the board
/DZQ: Ur.47 (DZQ); also elsewhere on the board
/HPFB: Ur.100 (HPOUTFB); also elsewhere on the board
/HPL: Ur.99 (HPOUTL); also elsewhere on the board
/HPR: Ur.98 (HPOUTR); also elsewhere on the board
/LDO-A: Ur.28 (LDOA-OUT); also elsewhere on the board
/LED0: Ur.15 (PC6); also elsewhere on the board
/LEDC: Ur.125 (PG13); also elsewhere on the board
/MIC_N: Ur.88 (MICIN3N); also elsewhere on the board
/MIC_P: Ur.87 (MICIN3P); also elsewhere on the board
/PWM5/PD21: Ur.53 (PD21); also elsewhere on the board
/PWM7/PD22: Ur.52 (PD22); also elsewhere on the board
/REF_24M: Ur.21 (REFCLK-OUT); also elsewhere on the board
/RESET: Ur.27 (RESET); also elsewhere on the board
/SD0_CLK: Ur.9 (PF2); also elsewhere on the board
/SD0_CMD: Ur.10 (PF3); also elsewhere on the board
/SD0_D0: Ur.8 (PF1); also elsewhere on the board
/SD0_D1: Ur.7 (PF0); also elsewhere on the board
/SD0_D2: Ur.12 (PF5); also elsewhere on the board
/SD0_D3: Ur.11 (PF4); also elsewhere on the board
/SD1_CLK: Ur.120 (PG0); also elsewhere on the board
/SD1_CMD: Ur.118 (PG1); also elsewhere on the board
/SD1_D0: Ur.119 (PG2); also elsewhere on the board
/SD1_D1: Ur.121 (PG3); also elsewhere on the board
/SD1_D2: Ur.123 (PG4); also elsewhere on the board
/SD1_D3: Ur.122 (PG5); also elsewhere on the board
/SPI0_CLK: Ur.19 (PC2); also elsewhere on the board
/SPI0_CS: Ur.18 (PC3); also elsewhere on the board
/SPI0_MISO/SEL1: Ur.16 (PC5); also elsewhere on the board
/SPI0_MOSI/SEL0: Ur.17 (PC4); also elsewhere on the board
/SPI1_CLK: Ur.68 (PD11); also elsewhere on the board
/SPI1_CS: Ur.67 (PD10); also elsewhere on the board
/SPI1_HOLD: Ur.71 (PD14); also elsewhere on the board
/SPI1_MISO: Ur.69 (PD13); also elsewhere on the board
/SPI1_MOSI: Ur.70 (PD12); also elsewhere on the board
/SPI1_WP: Ur.72 (PD15); also elsewhere on the board
/SW0: Ur.13 (PF6); also elsewhere on the board
/SW1: Ur.14 (PC7); also elsewhere on the board
/TP_X1: Ur.102 (TP-X1); also elsewhere on the board
/TP_X2: Ur.103 (TP-X2); also elsewhere on the board
/TP_Y1: Ur.104 (TP-Y1); also elsewhere on the board
/TP_Y2: Ur.105 (TP-Y2); also elsewhere on the board
/TWI2_SCK: Ur.32 (PE12); also elsewhere on the board
/TWI2_SDA: Ur.31 (PE13); also elsewhere on the board
/UART1_CTS: Ur.4 (PG9); also elsewhere on the board
/UART1_RTS: Ur.3 (PG8); also elsewhere on the board
/UART1_RX: Ur.2 (PG7); also elsewhere on the board
/UART1_TX: Ur.1 (PG6); also elsewhere on the board
/UART3_RX: Ur.79 (PB7); also elsewhere on the board
/UART3_TX: Ur.80 (PB6); also elsewhere on the board
/UART5_RX: Ur.82 (PB5); also elsewhere on the board
/UART5_TX: Ur.84 (PB4); also elsewhere on the board
/USB0_DN: Ur.114 (USB0-DM); also elsewhere on the board
/USB0_DP: Ur.115 (USB0-DP); also elsewhere on the board
/USB1_DN: Ur.113 (USB1-DM); also elsewhere on the board
/USB1_DP: Ur.112 (USB1-DP); also elsewhere on the board
/VRA1: Ur.92 (VRA1); also elsewhere on the board
/VRA2: Ur.90 (VRA2); also elsewhere on the board
/WL_RST: Ur.127 (PG15); also elsewhere on the board
/WL_WAKE: Ur.126 (PG14); also elsewhere on the board
GND: Ur.91 (AGND), Ur.129 (EPAD); also elsewhere on the board
